Headmaster218/SkyGrip/Medias/Arm_load_test.PNG

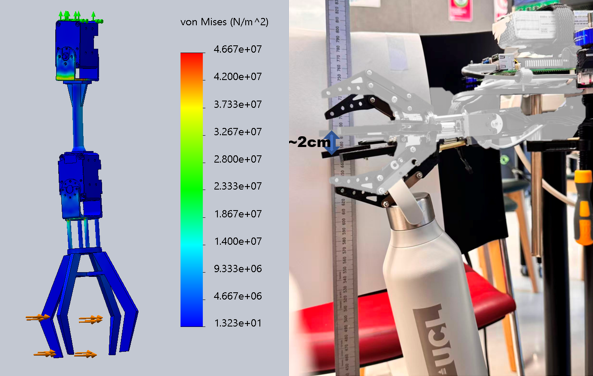
Medias/Arm_load_test.PNG
