Headmaster218/SkyGrip/3D Model/Manipulator/pics/Raspberry Pi 5.JPG

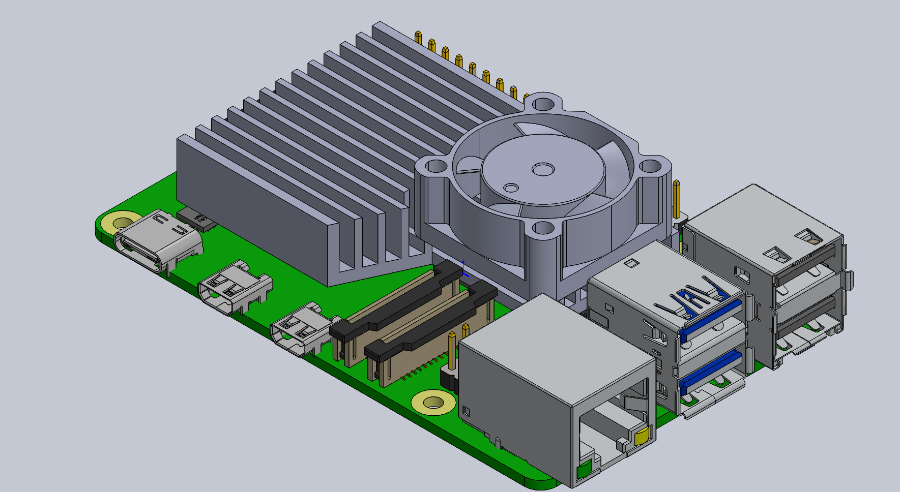
3D Model/Manipulator/pics/Raspberry Pi 5.JPG
