Headmaster218/SkyGrip/3D Model/Manipulator/pics/Arm_FEA1.PNG

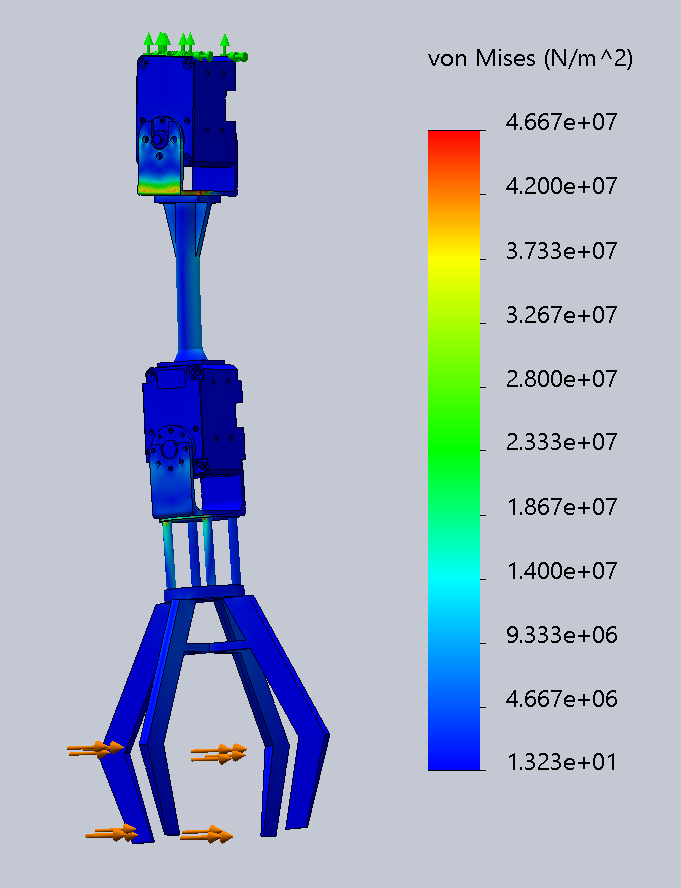
3D Model/Manipulator/pics/Arm_FEA1.PNG
