Headmaster218/SkyGrip/3D Model/Manipulator/pics/Arm_FEA.PNG

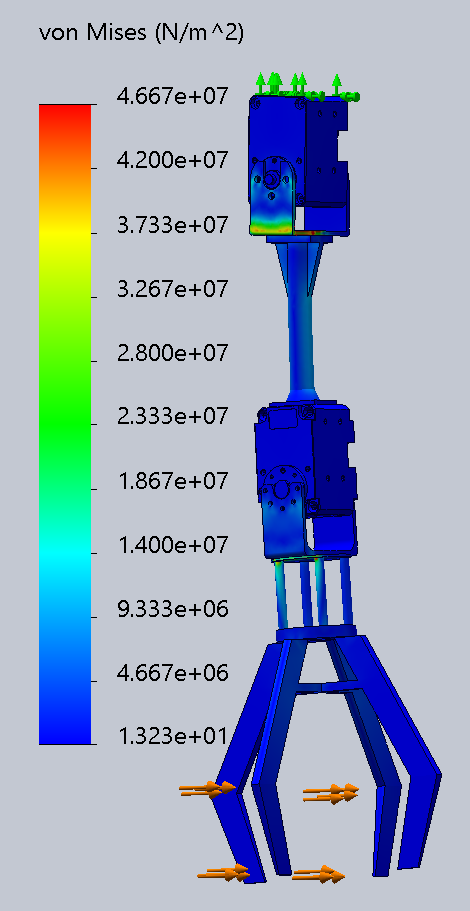
3D Model/Manipulator/pics/Arm_FEA.PNG
