Headmaster218/SkyGrip/3D Model/Manipulator/pics/arm_link.JPG

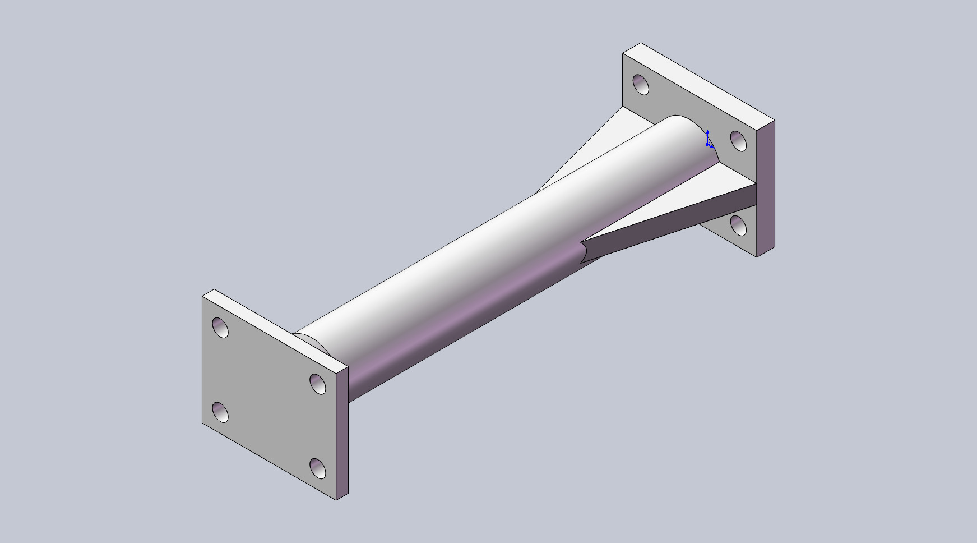
3D Model/Manipulator/pics/arm_link.JPG
