Headmaster218/SkyGrip/3D Model/Manipulator/pics/claw open.JPG

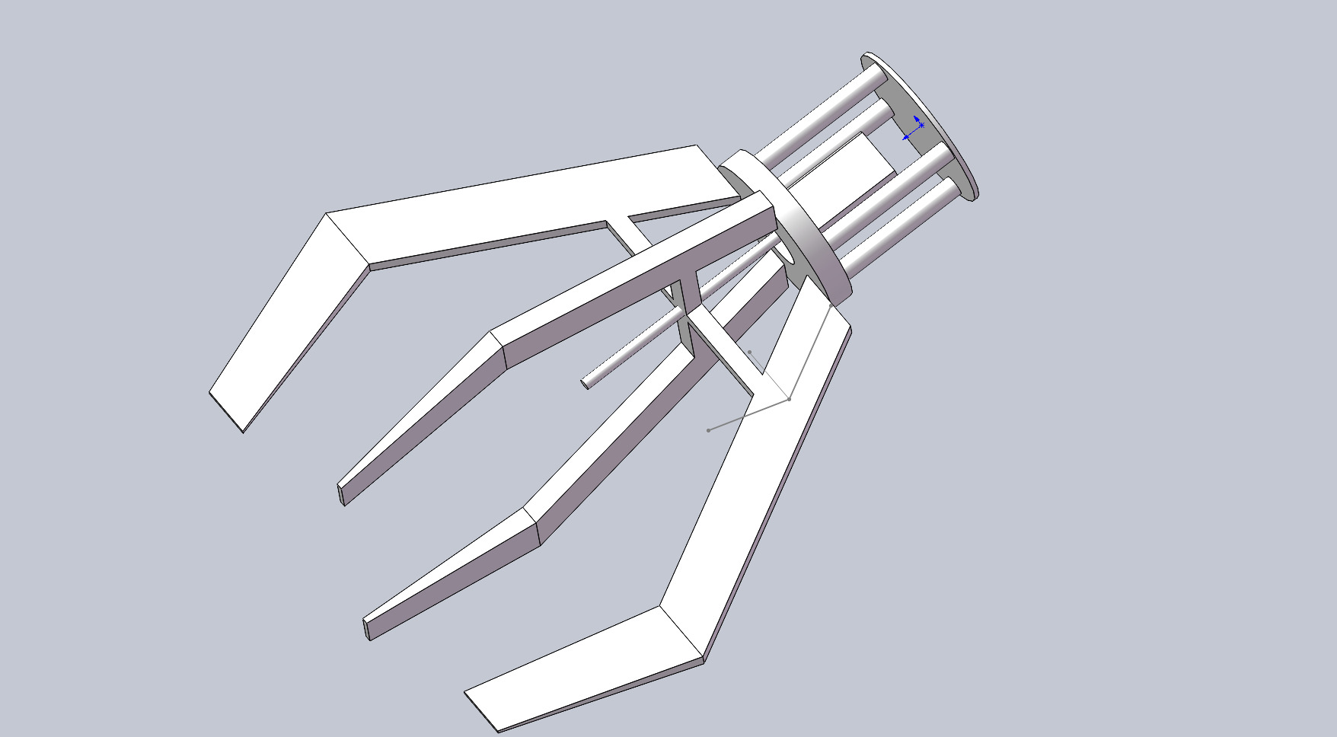
3D Model/Manipulator/pics/claw open.JPG
