Headmaster218/SkyGrip/3D Model/Manipulator/pics/connector_joint1.JPG

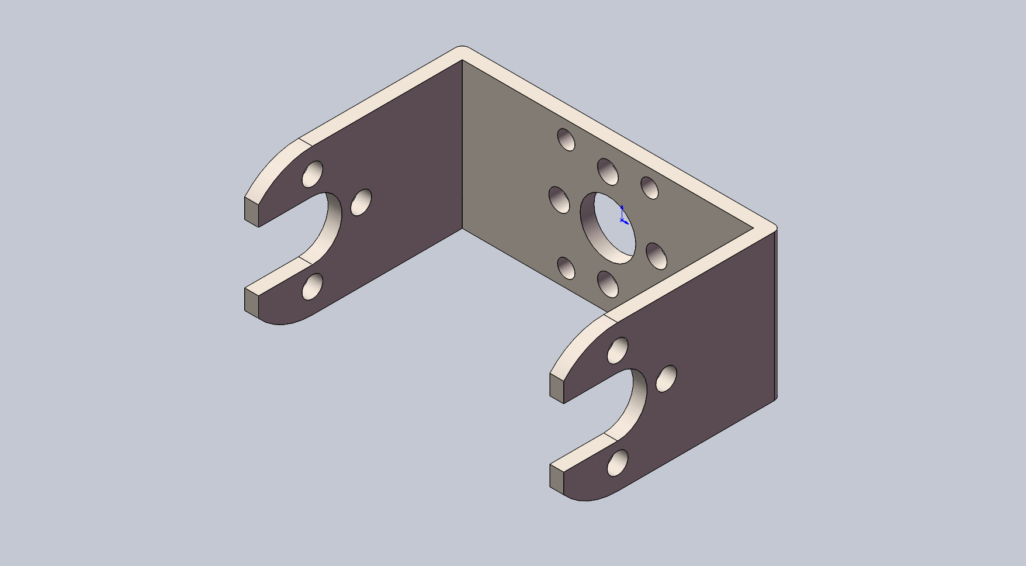
3D Model/Manipulator/pics/connector_joint1.JPG
