Headmaster218/SkyGrip/3D Model/Manipulator/pics/drone.JPG

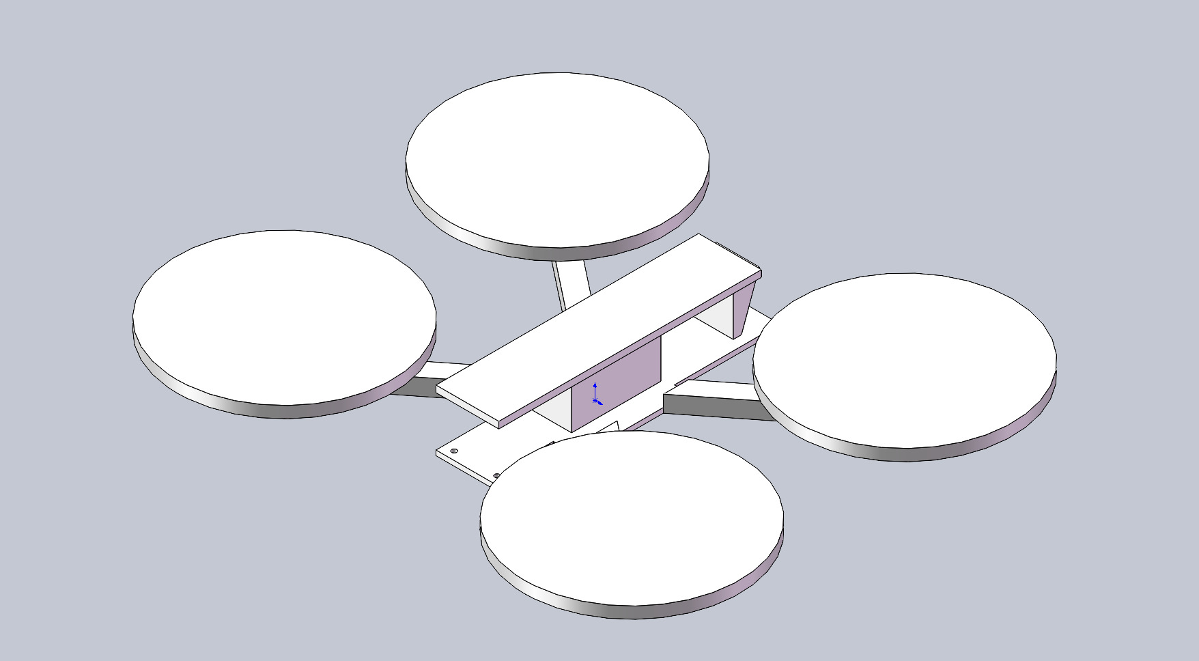
3D Model/Manipulator/pics/drone.JPG
