Headmaster218/SkyGrip/3D Model/Manipulator/pics/motor2.JPG

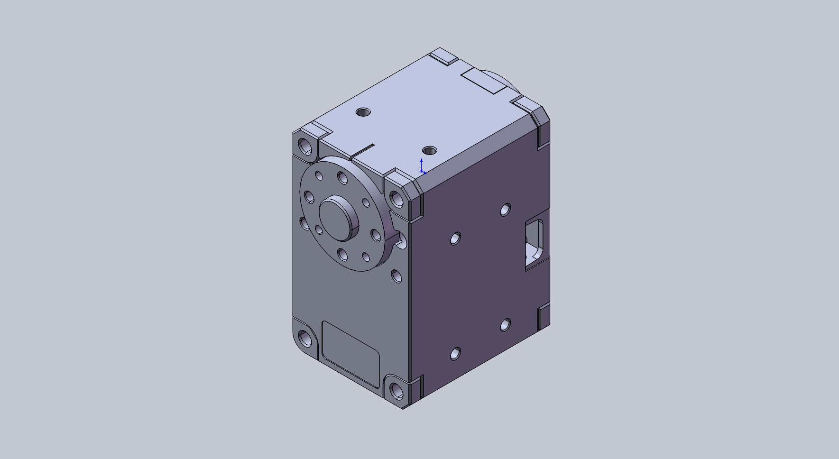
3D Model/Manipulator/pics/motor2.JPG
