Headmaster218/SkyGrip/3D Model/Manipulator/pics/motor2drone.JPG

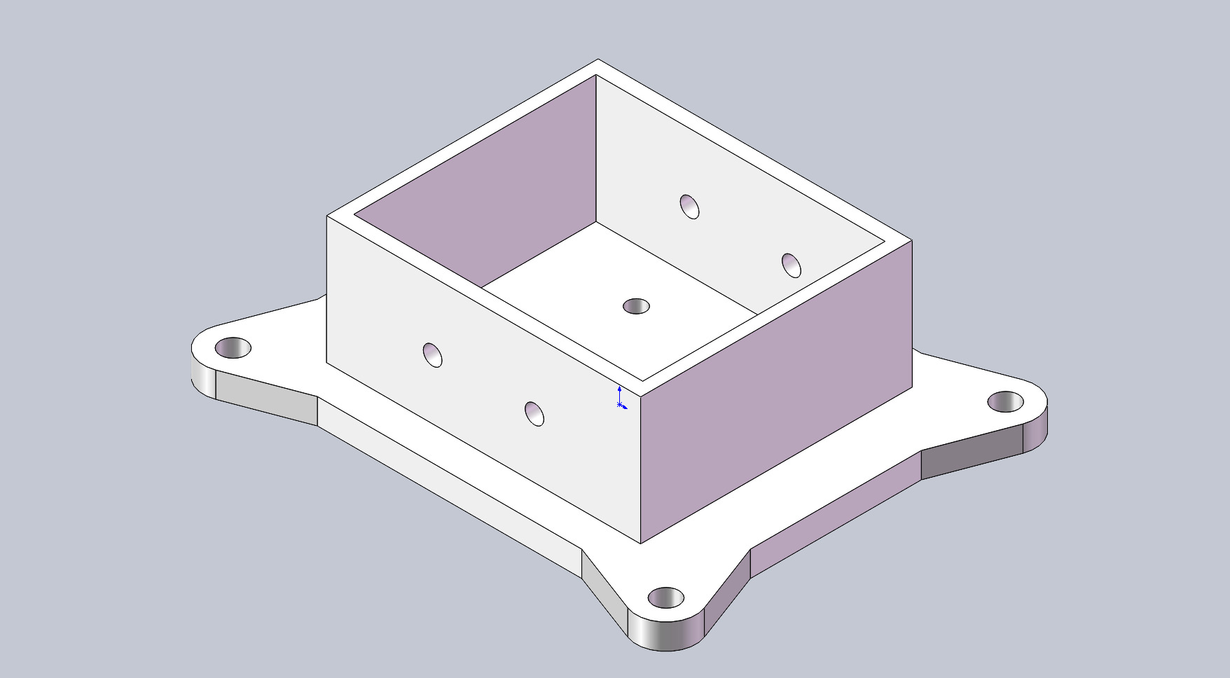
3D Model/Manipulator/pics/motor2drone.JPG
