Headmaster218/SkyGrip/3D Model/Manipulator/pics/raspi_shelf.JPG

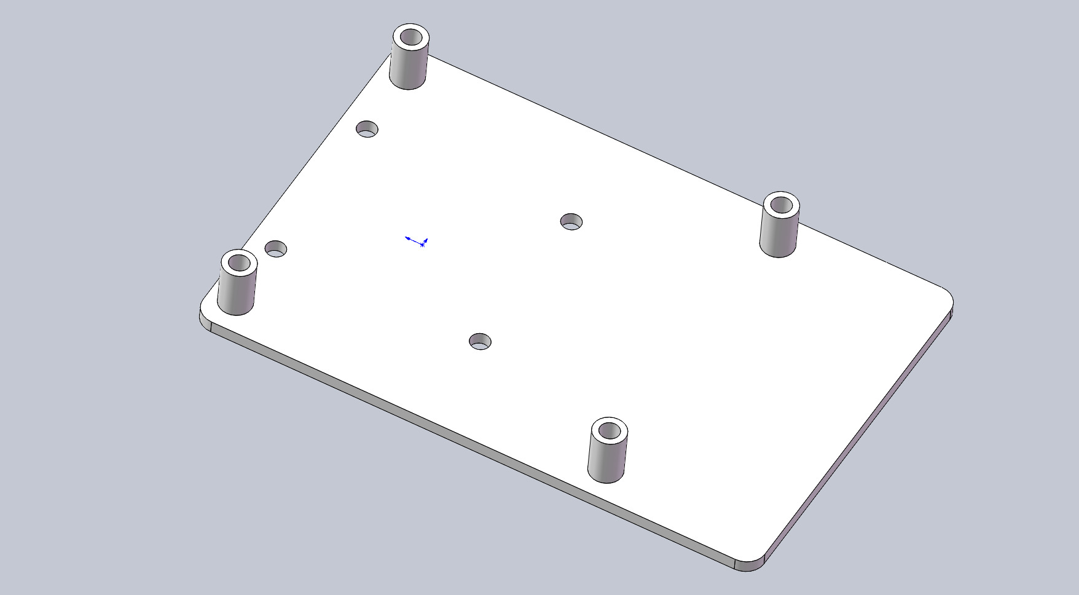
3D Model/Manipulator/pics/raspi_shelf.JPG
