Headmaster218/SkyGrip/Medias/EE_Square_rmse_heatmap.png

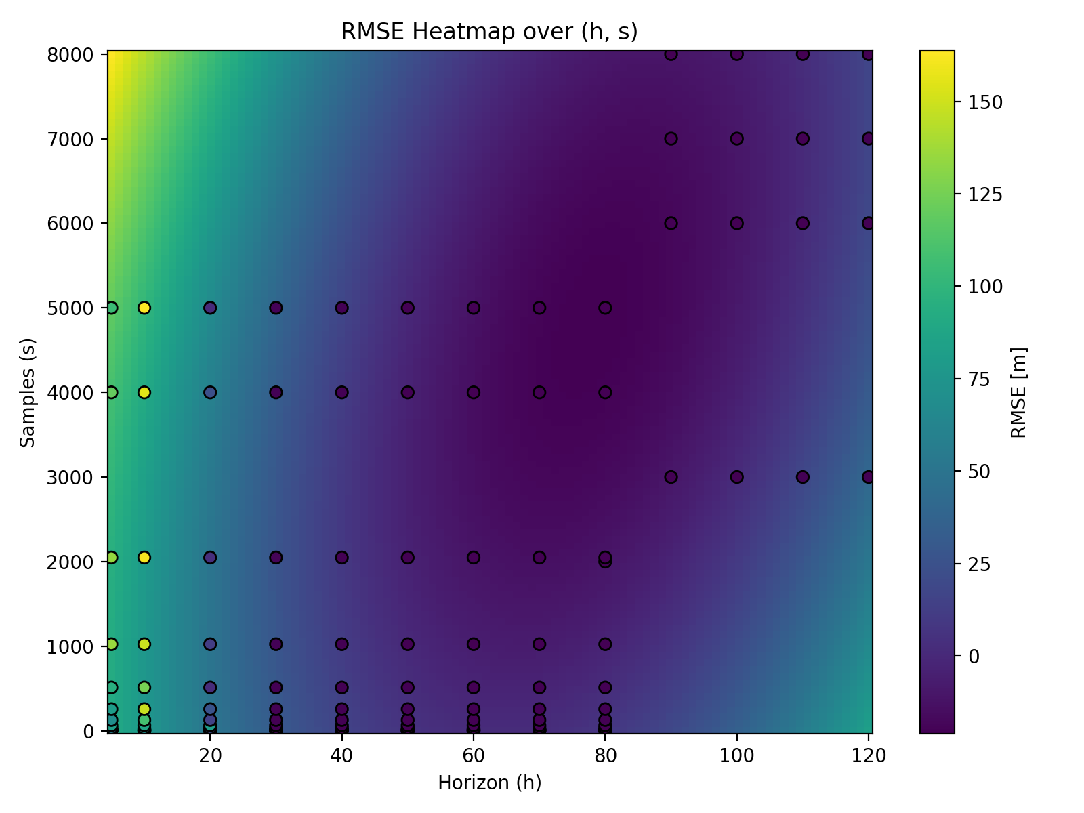
Medias/EE_Square_rmse_heatmap.png
