Headmaster218/SkyGrip/Medias/MPPI vs RS_MPC vs Myopic.png

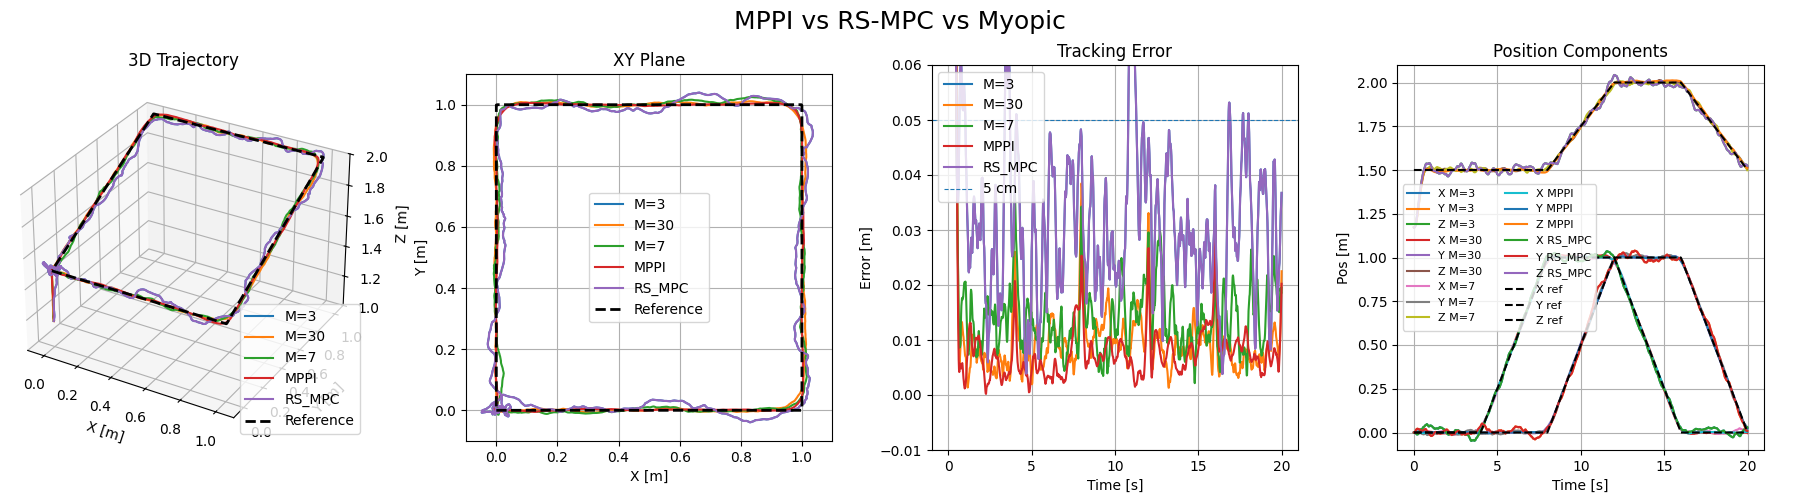
Medias/MPPI vs RS_MPC vs Myopic.png
