Headmaster218/SkyGrip/Medias/sim_n_real1.jpg

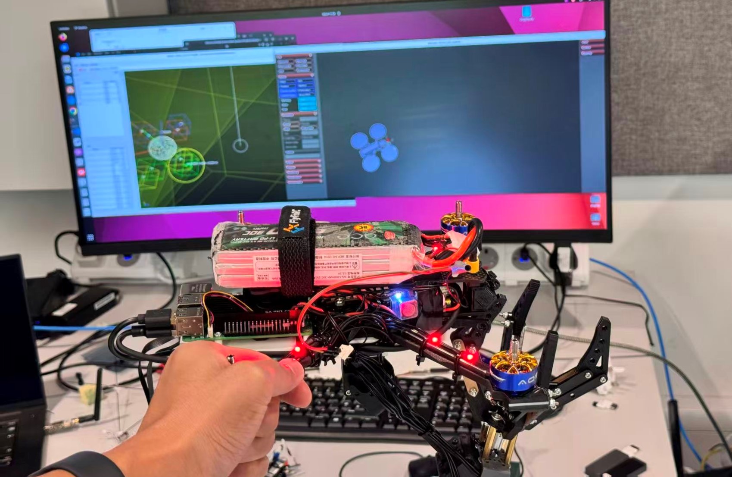
Medias/sim_n_real1.jpg
