Headmaster218/SkyGrip/Medias/sim_n_real.png

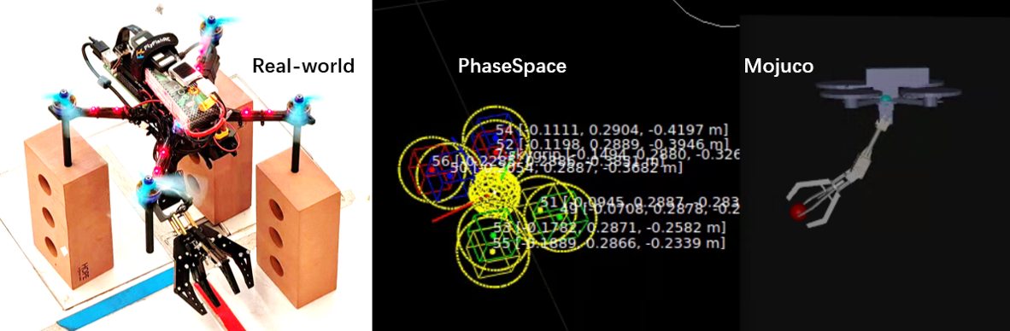
Medias/sim_n_real.png
