Headmaster218/SkyGrip/Medias/square_trace_H_80.png

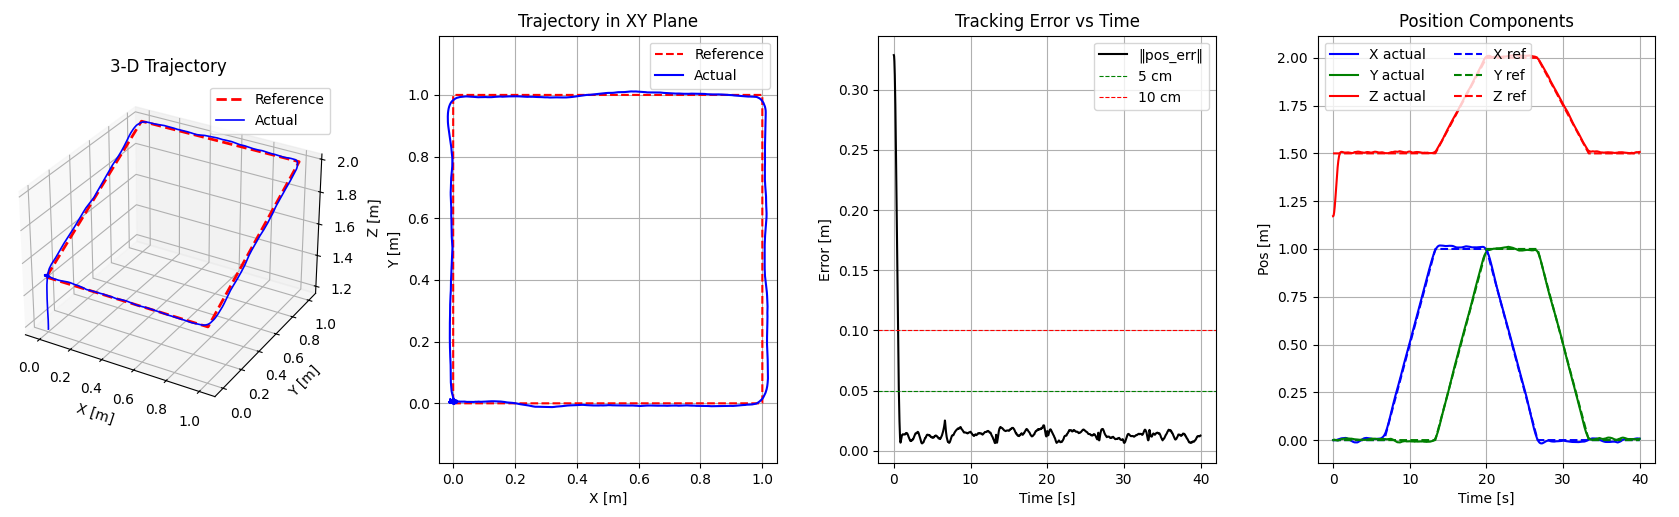
Medias/square_trace_H_80.png
