Headmaster218/SkyGrip/Medias/square_trace_H_80_remove_part_loss.png

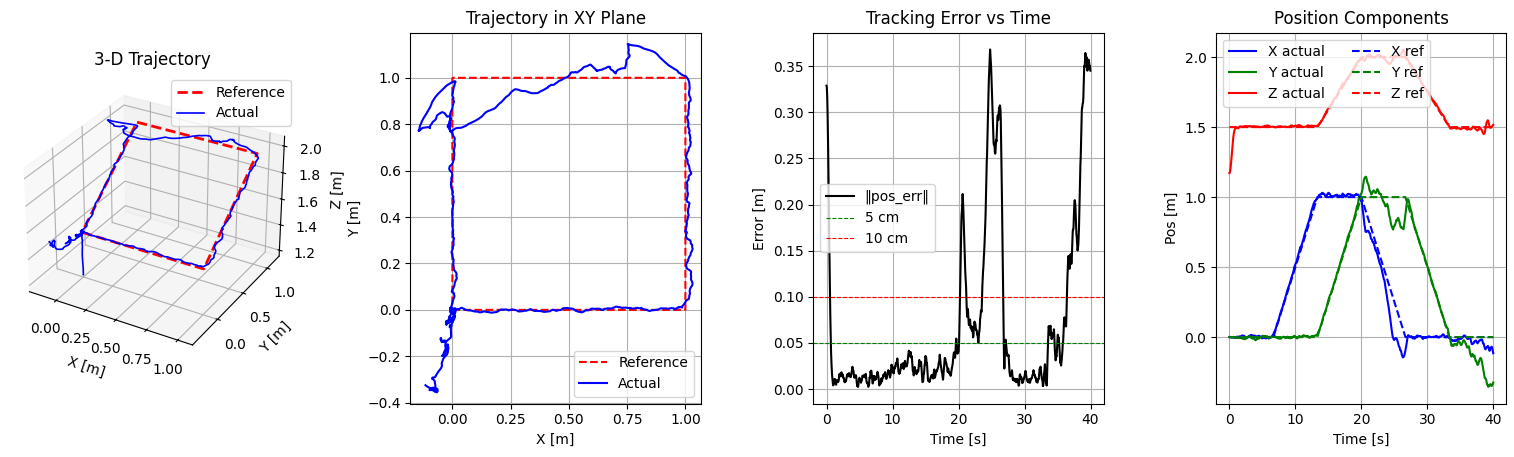
Medias/square_trace_H_80_remove_part_loss.png
