Headmaster218/SkyGrip/Medias/sys_archetecture_rough.PNG

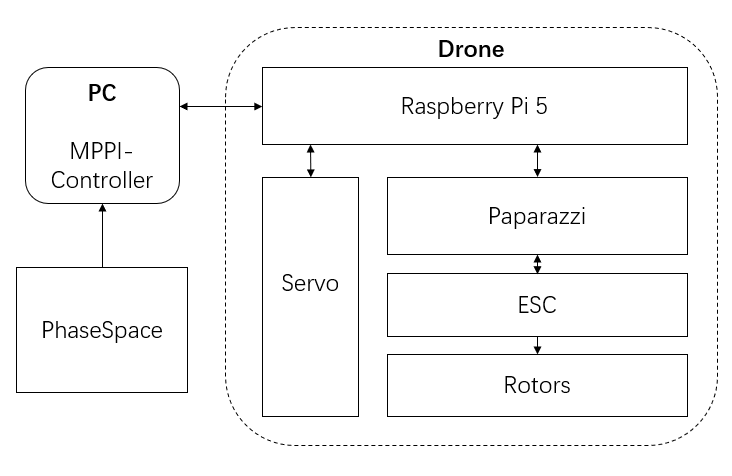
Medias/sys_archetecture_rough.PNG
