Headmaster218/SkyGrip/Sim'n'Real/Mujoco/base_link.STL

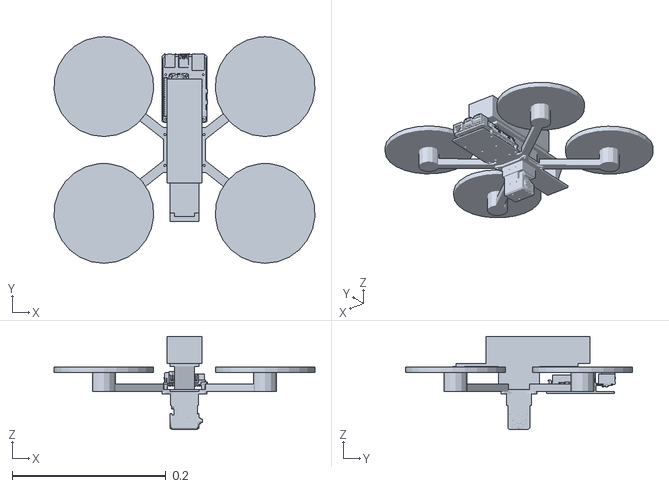
[picture p34: CAD file, 2025-08-15]
Sim'n'Real/Mujoco/base_link.STL
0.34 x 0.295 x 0.121
