Headmaster218/SkyGrip/Sim'n'Real/PyBullet/models/mppi/Link_2.stl

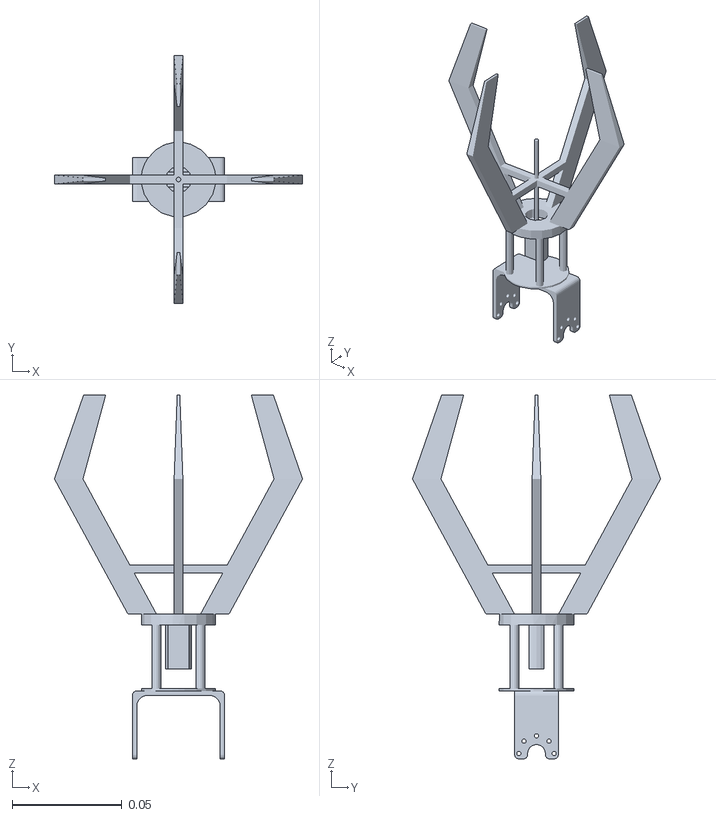
[picture p35: CAD file, 2025-08-08]
Sim'n'Real/PyBullet/models/mppi/Link_2.stl
0.113 x 0.113 x 0.166
