Headmaster218/SkyGrip/3D Model/Manipulator/motor2drone.STEP

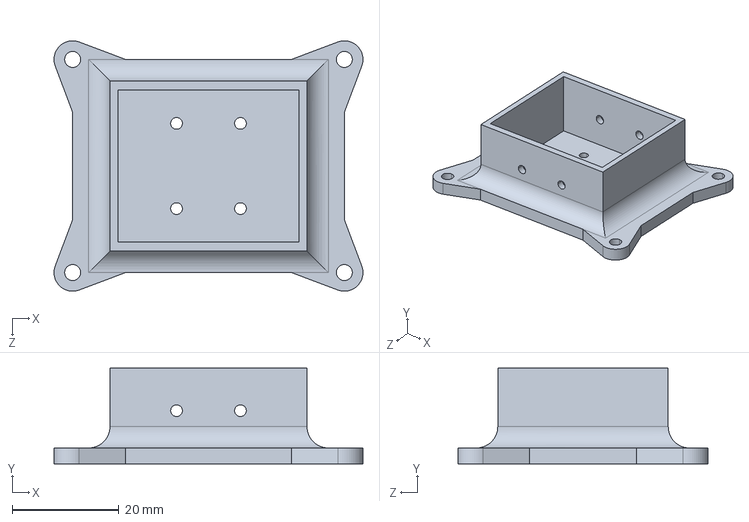
[picture p36: CAD file, 2025-09-08]
3D Model/Manipulator/motor2drone.STEP
58.0 x 18.0 x 47.0 mm
