Headmaster218/SkyGrip/3D Model/Supersonic/realsense.SLDPRT

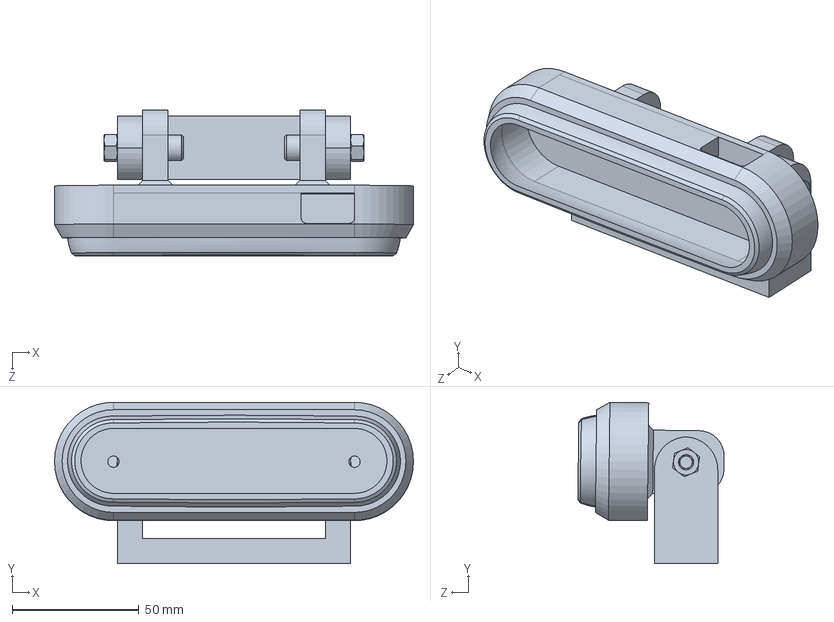
[picture p37: CAD file, 2025-08-19]
3D Model/Supersonic/realsense.SLDPRT
141.5 x 63.6 x 57.7 mm
