Headmaster218/SkyGrip/Sim'n'Real/Mujoco/Link_1.STL

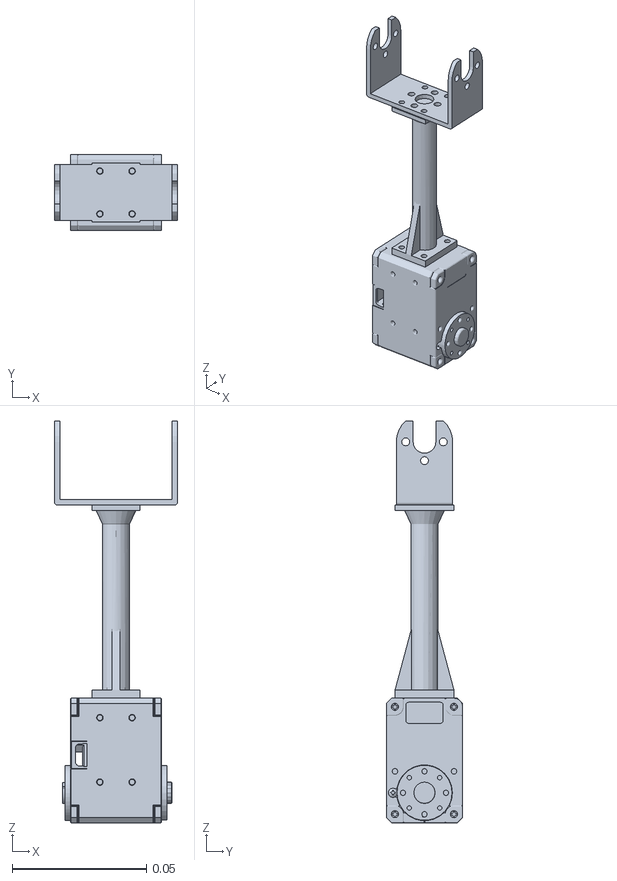
[picture p38: CAD file, 2025-08-08]
Sim'n'Real/Mujoco/Link_1.STL
0.0459 x 0.0285 x 0.15
