Headmaster218/SkyGrip/Sim'n'Real/PyBullet/models/mppi/Link_1.stl

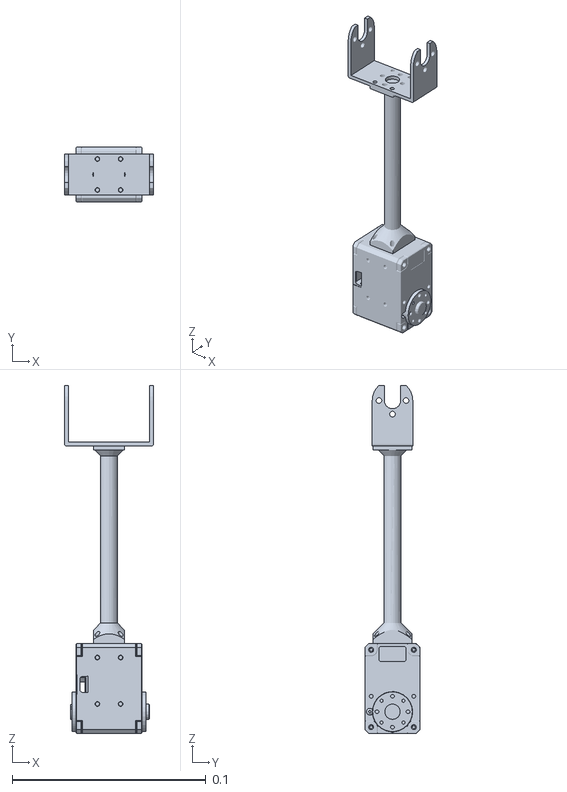
[picture p39: CAD file, 2025-06-22]
Sim'n'Real/PyBullet/models/mppi/Link_1.stl
0.0459 x 0.0285 x 0.18
