Headmaster218/SkyGrip/3D Model/Manipulator/arm.SLDPRT

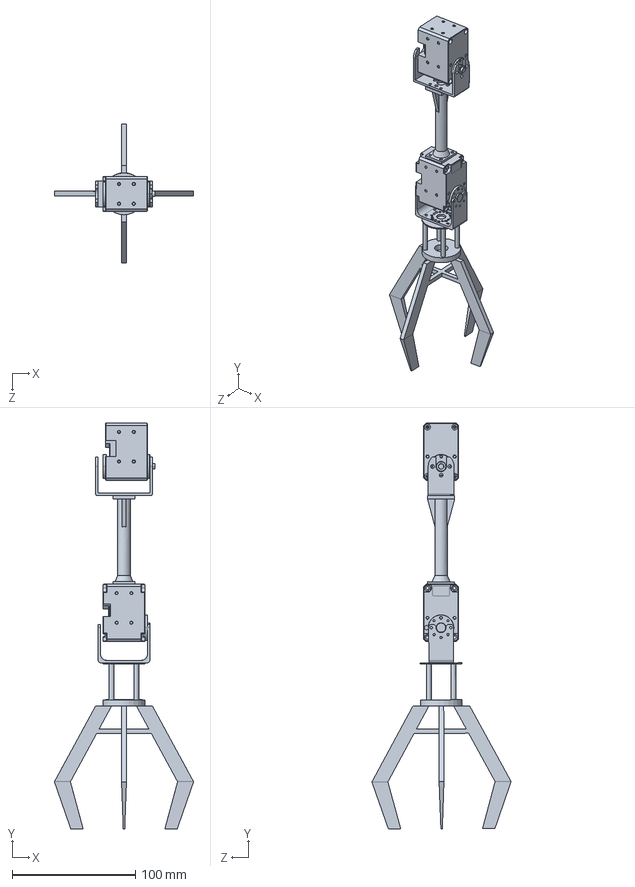
[picture p40: CAD file, 2025-09-04]
3D Model/Manipulator/arm.SLDPRT
113.0 x 329.4 x 113.0 mm
