Headmaster218/SkyGrip/3D Model/Supersonic/L_for_big.STEP

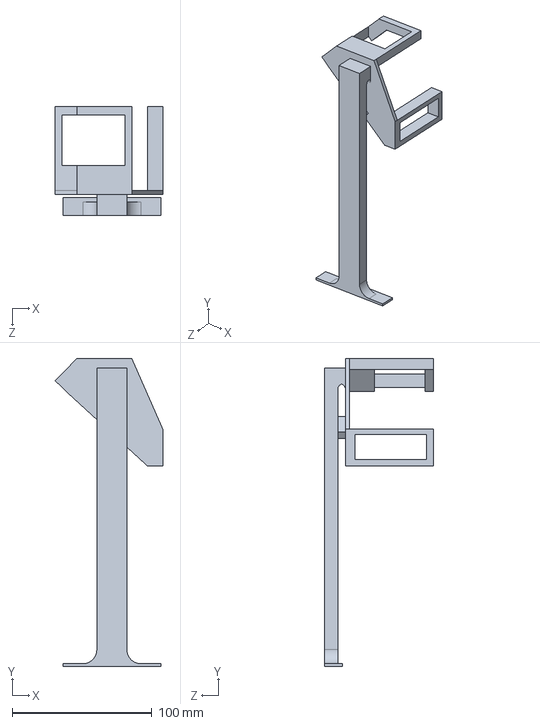
[picture p41: CAD file, 2025-08-18]
3D Model/Supersonic/L_for_big.STEP
76.9 x 220.1 x 78.0 mm
