Headmaster218/SkyGrip/Sim'n'Real/PyBullet/models/mppi/base_link.stl

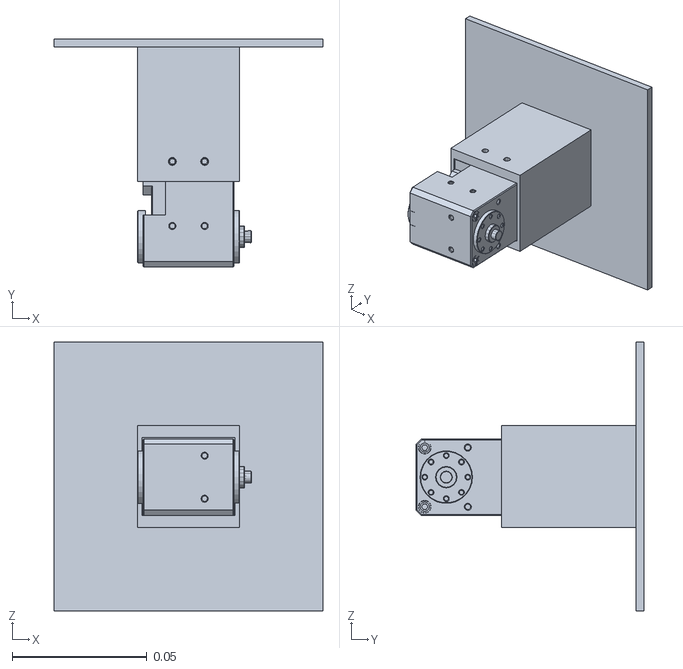
[picture p42: CAD file, 2025-06-22]
Sim'n'Real/PyBullet/models/mppi/base_link.stl
0.1 x 0.0848 x 0.1
