Headmaster218/SkyGrip/3D Model/Manipulator/drone_foot.STEP

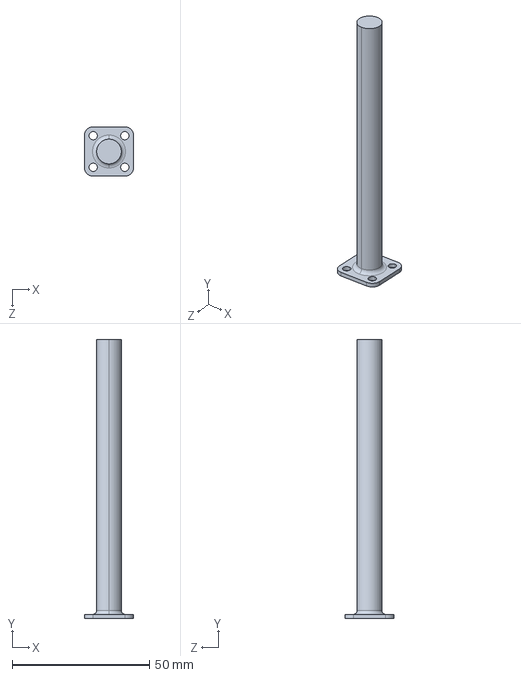
[picture p43: CAD file, 2025-09-04]
3D Model/Manipulator/drone_foot.STEP
18.0 x 101.5 x 18.0 mm
