Headmaster218/SkyGrip/3D Model/Supersonic/L_for_small.SLDPRT

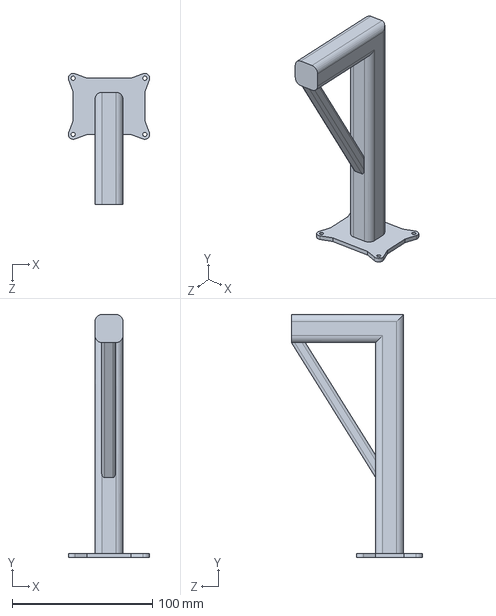
[picture p44: CAD file, 2025-08-18]
3D Model/Supersonic/L_for_small.SLDPRT
58.0 x 173.0 x 93.5 mm
