Headmaster218/SkyGrip/3D Model/Manipulator/drone.SLDPRT

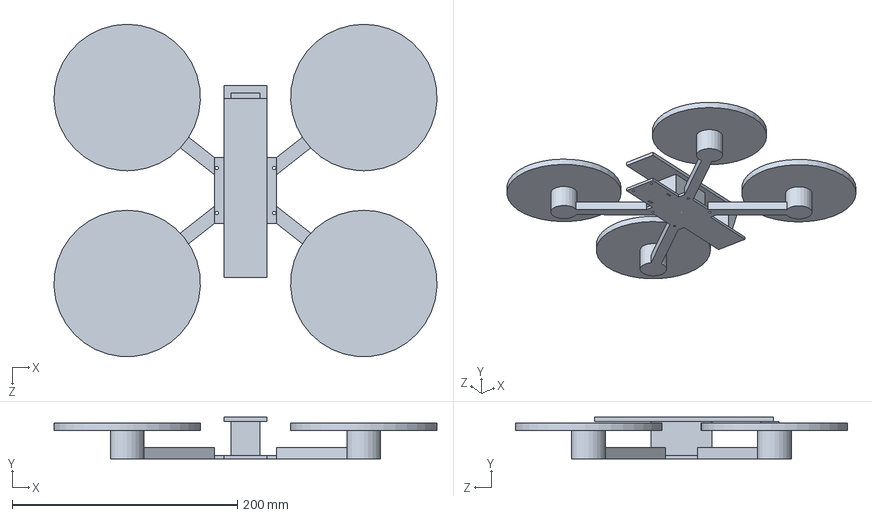
[picture p45: CAD file, 2025-08-08]
3D Model/Manipulator/drone.SLDPRT
339.9 x 37.0 x 295.0 mm
