Headmaster218/SkyGrip/3D Model/Manipulator/battery.SLDPRT

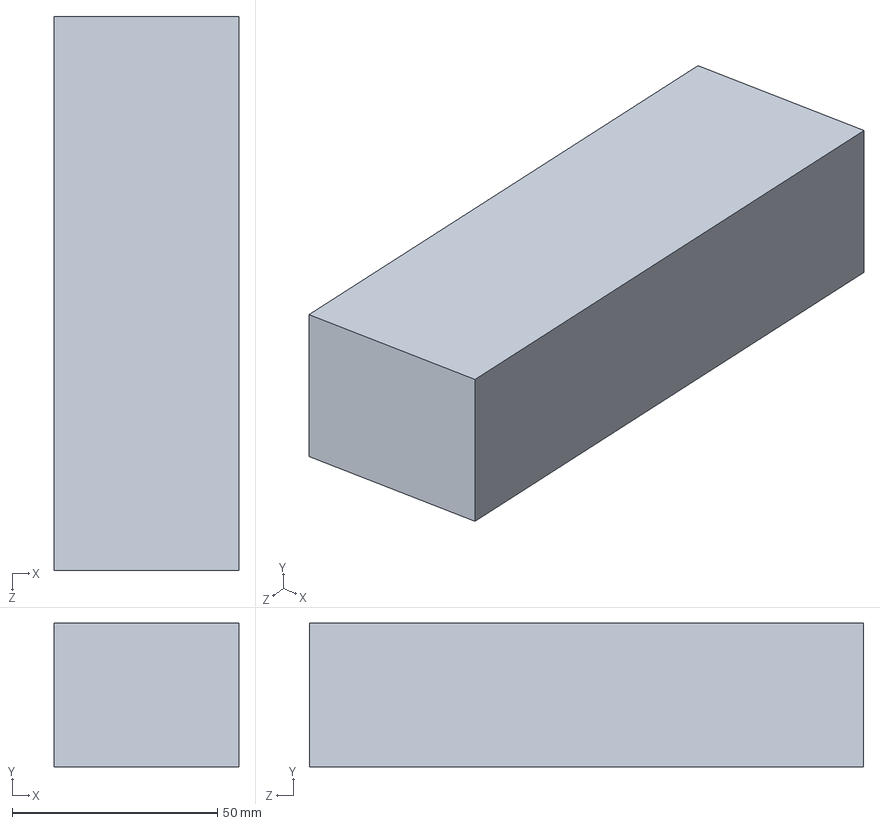
[picture p46: CAD file, 2025-08-07]
3D Model/Manipulator/battery.SLDPRT
45.0 x 35.0 x 135.0 mm
