Headmaster218/SkyGrip/3D Model/Manipulator/raspi_shelf.STEP

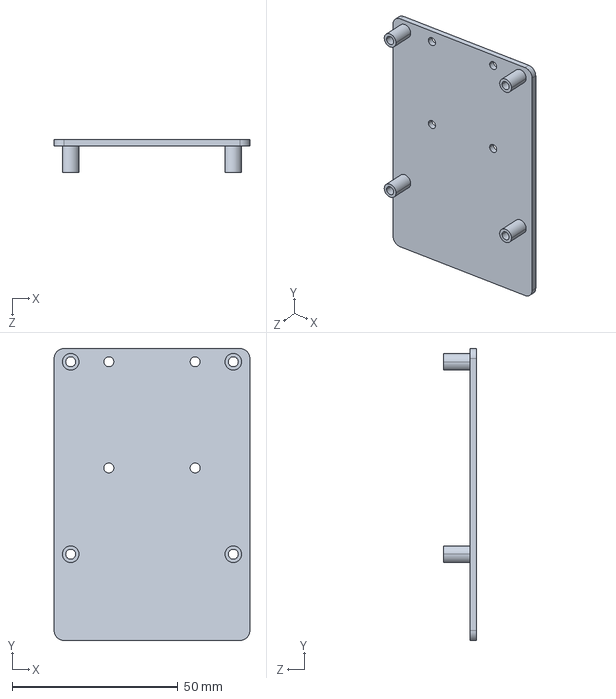
[picture p47: CAD file, 2025-08-07]
3D Model/Manipulator/raspi_shelf.STEP
59.0 x 88.0 x 10.0 mm
