Headmaster218/SkyGrip/3D Model/Manipulator/arm_link.STEP

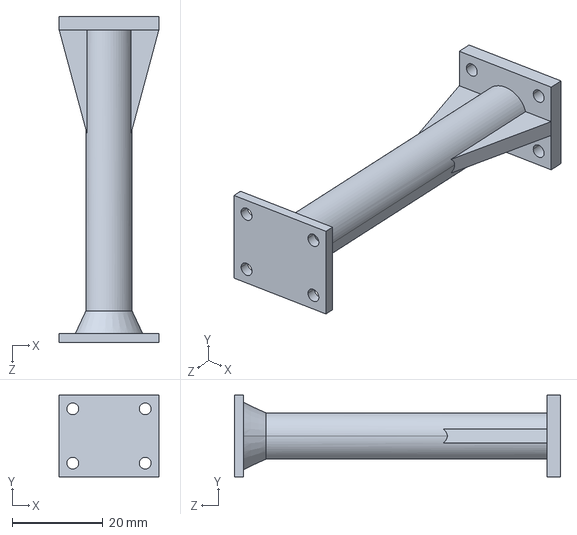
[picture p48: CAD file, 2025-08-06]
3D Model/Manipulator/arm_link.STEP
22.0 x 18.0 x 72.0 mm
