Headmaster218/SkyGrip/3D Model/Manipulator/connector_joint2.SLDPRT

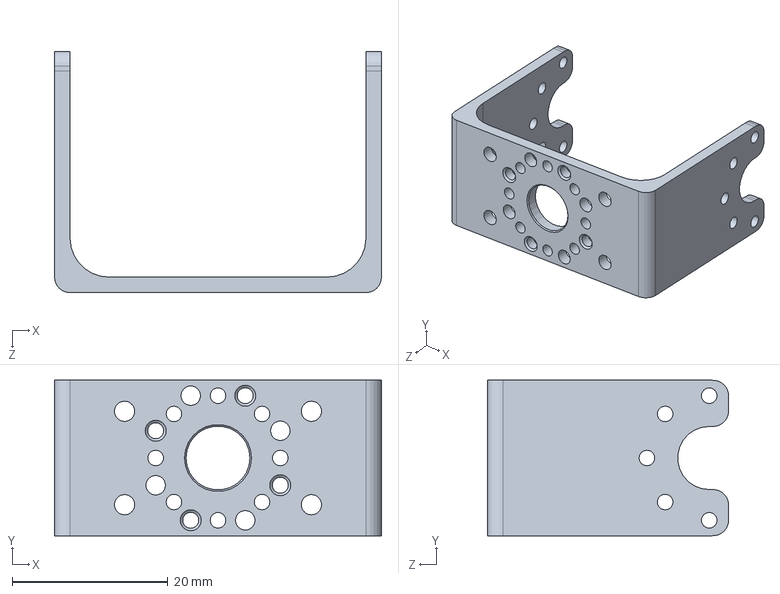
[picture p49: CAD file, 2025-08-06]
3D Model/Manipulator/connector_joint2.SLDPRT
42.0 x 20.0 x 31.0 mm
