Headmaster218/SkyGrip/3D Model/Manipulator/claw open.SLDPRT

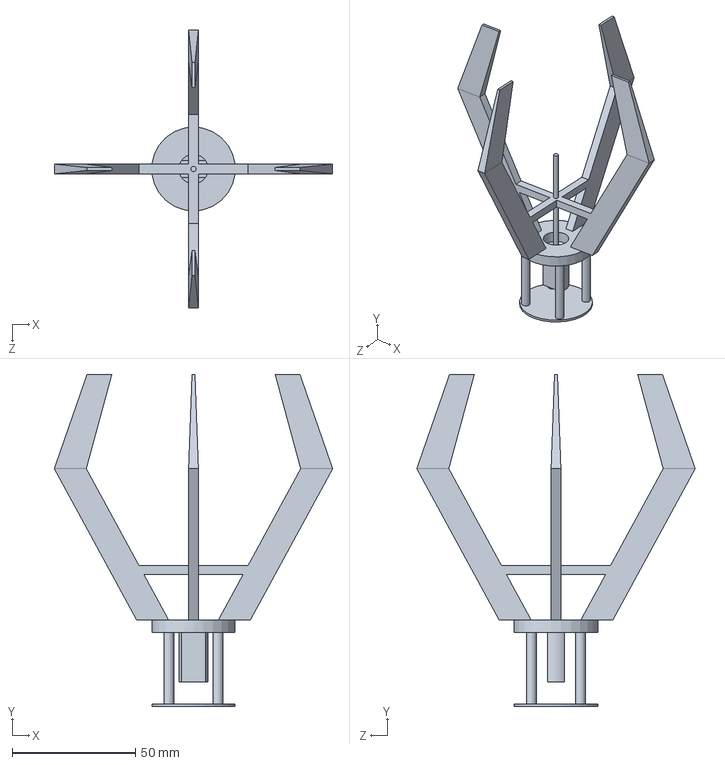
[picture p50: CAD file, 2025-08-06]
3D Model/Manipulator/claw open.SLDPRT
113.0 x 134.7 x 113.0 mm
