Headmaster218/SkyGrip/3D Model/Manipulator/motor2.SLDPRT

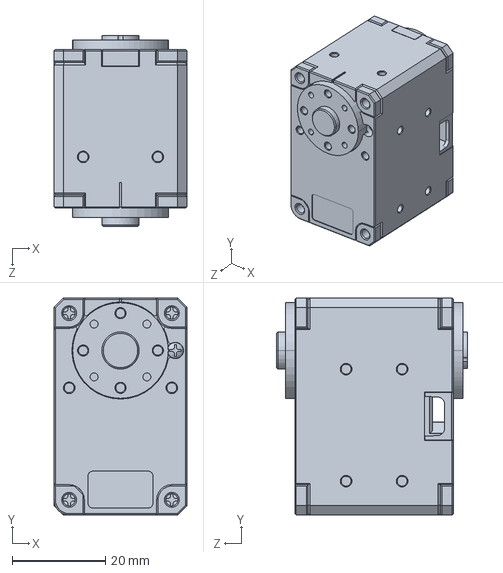
[picture p51: CAD file, 2025-06-22]
3D Model/Manipulator/motor2.SLDPRT
28.5 x 46.5 x 40.9 mm
