Headmaster218/SkyGrip/3D Model/Manipulator/connector_joint1.SLDPRT

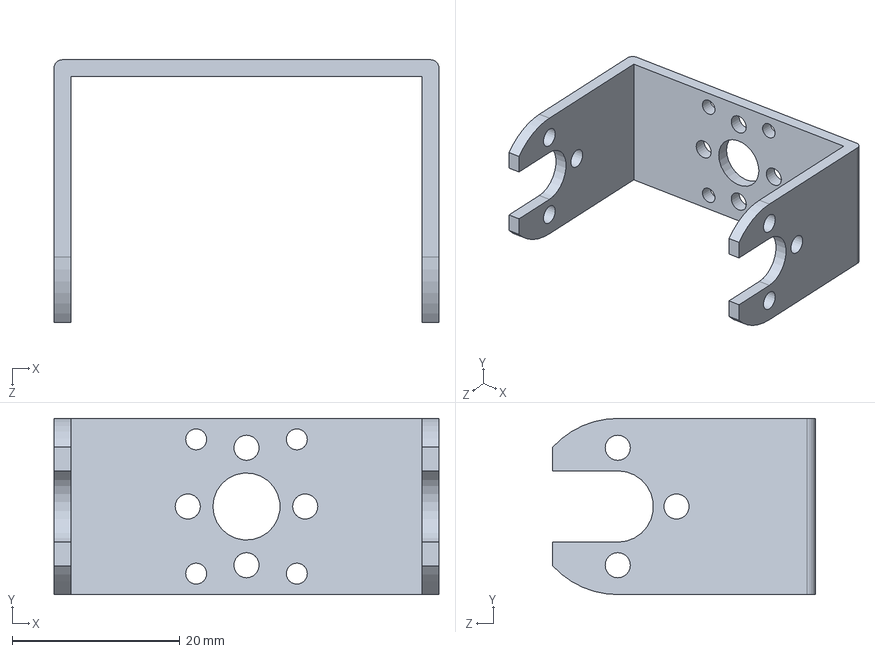
[picture p52: CAD file, 2025-06-22]
3D Model/Manipulator/connector_joint1.SLDPRT
45.9 x 21.0 x 31.3 mm
