Headmaster218/SkyGrip/3D Model/Manipulator/motor1.SLDPRT

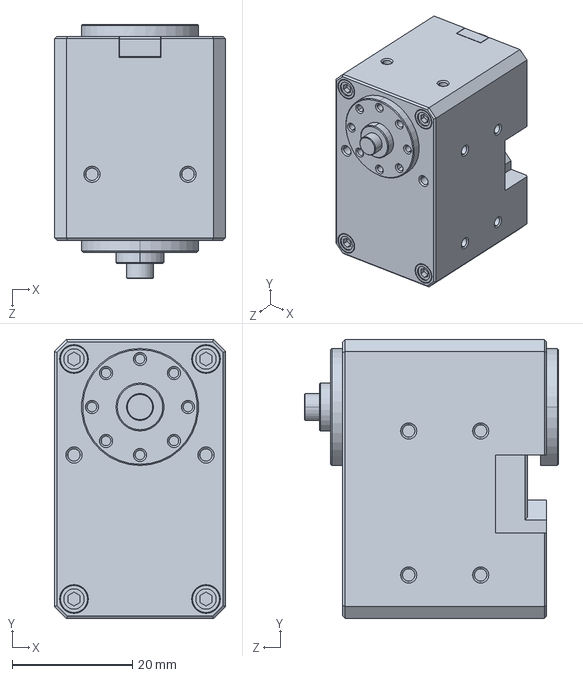
[picture p53: CAD file, 2025-06-22]
3D Model/Manipulator/motor1.SLDPRT
28.5 x 46.5 x 42.4 mm
