Headmaster218/SkyGrip/3D Model/Manipulator/Base.SLDPRT

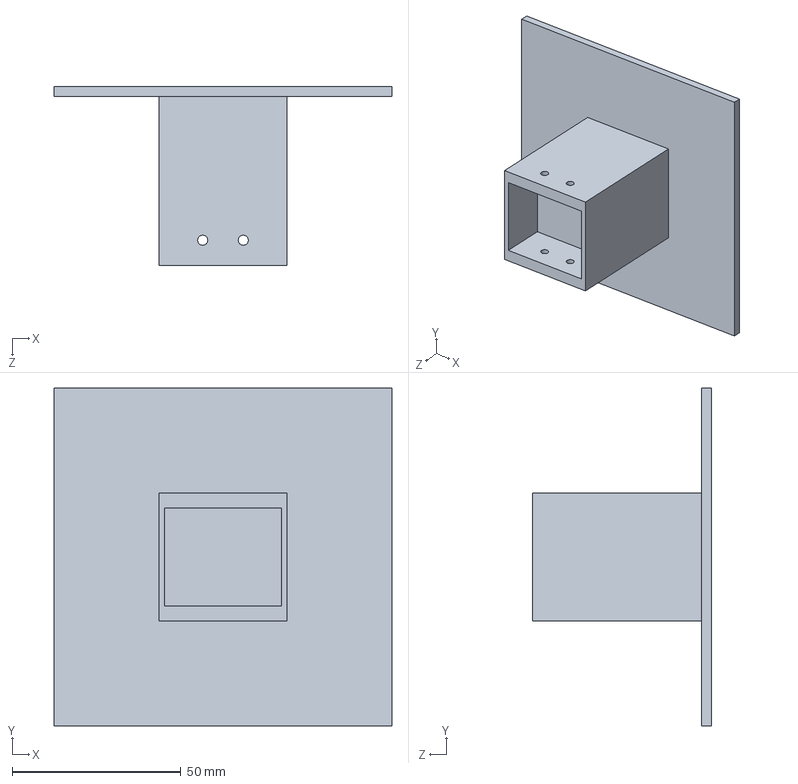
[picture p54: CAD file, 2025-06-22]
3D Model/Manipulator/Base.SLDPRT
100.0 x 100.0 x 53.0 mm
