Headmaster218/SkyGrip/3D Model/Manipulator/little bearing.SLDPRT

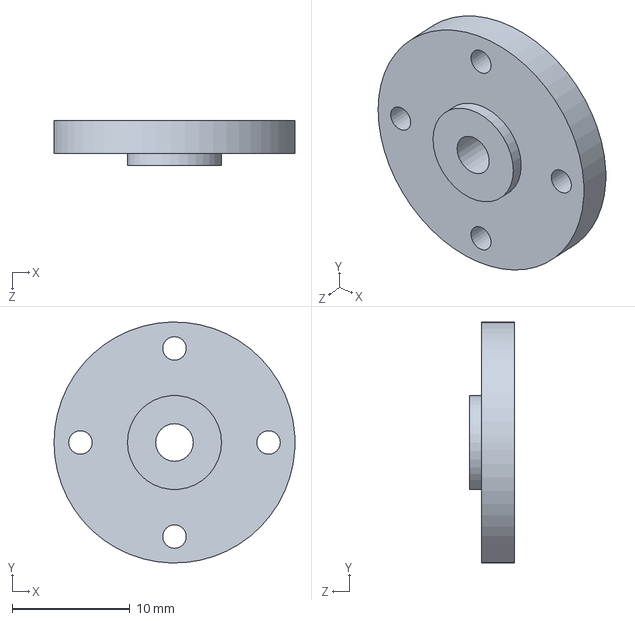
[picture p55: CAD file, 2025-06-22]
3D Model/Manipulator/little bearing.SLDPRT
20.5 x 20.5 x 3.80 mm
