Headmaster218/SkyGrip/3D Model/Manipulator/Skygrip.SLDASM

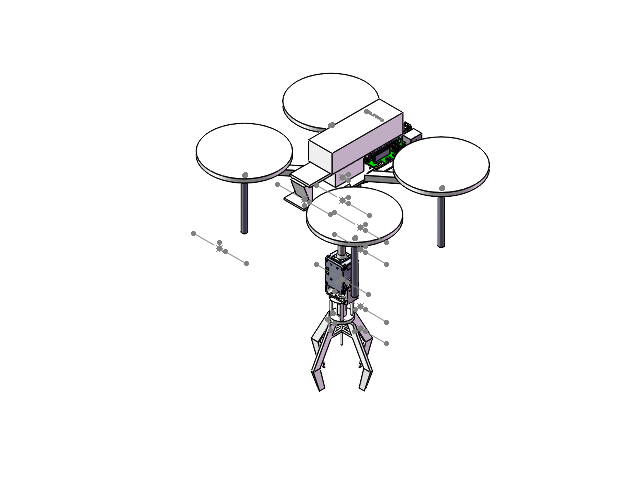
[picture p56: CAD file, 2025-09-08]
3D Model/Manipulator/Skygrip.SLDASM
connector_joint1
arm_link
connector_joint2
motor1
motor2
drone
claw open
raspi_shelf
Raspberry Pi 5
motor2drone
battery
drone_foot x 4
