Headmaster218/SkyGrip/3D Model/Supersonic/Link_2_new.SLDASM

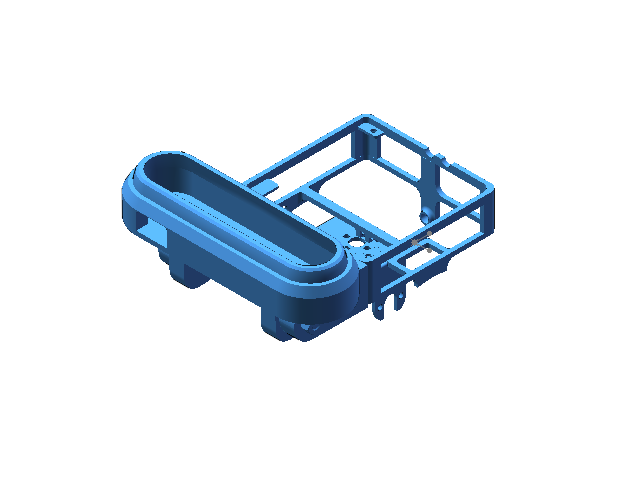
[picture p57: CAD file, 2025-08-20]
3D Model/Supersonic/Link_2_new.SLDASM
connector1
board_connector
realsense
