Headmaster218/SkyGrip/(list of files, cad)

Other CAD files:
3D Model/Manipulator/arm_link.SLDPRT
3D Model/Manipulator/drone_foot.SLDPRT
3D Model/Manipulator/motor2drone.SLDPRT
3D Model/Manipulator/raspi_shelf.SLDPRT
3D Model/Supersonic/L_for_big.SLDPRT
3D Model/Supersonic/Link_2_new.STL
