Headmaster218/SkyGrip/3D Model/Manipulator/PerformanceLog.txt

Number of Contacts: 32
Number of contact data: 5015
