Headmaster218/SkyGrip/Medias/Arm Perturbation test.png

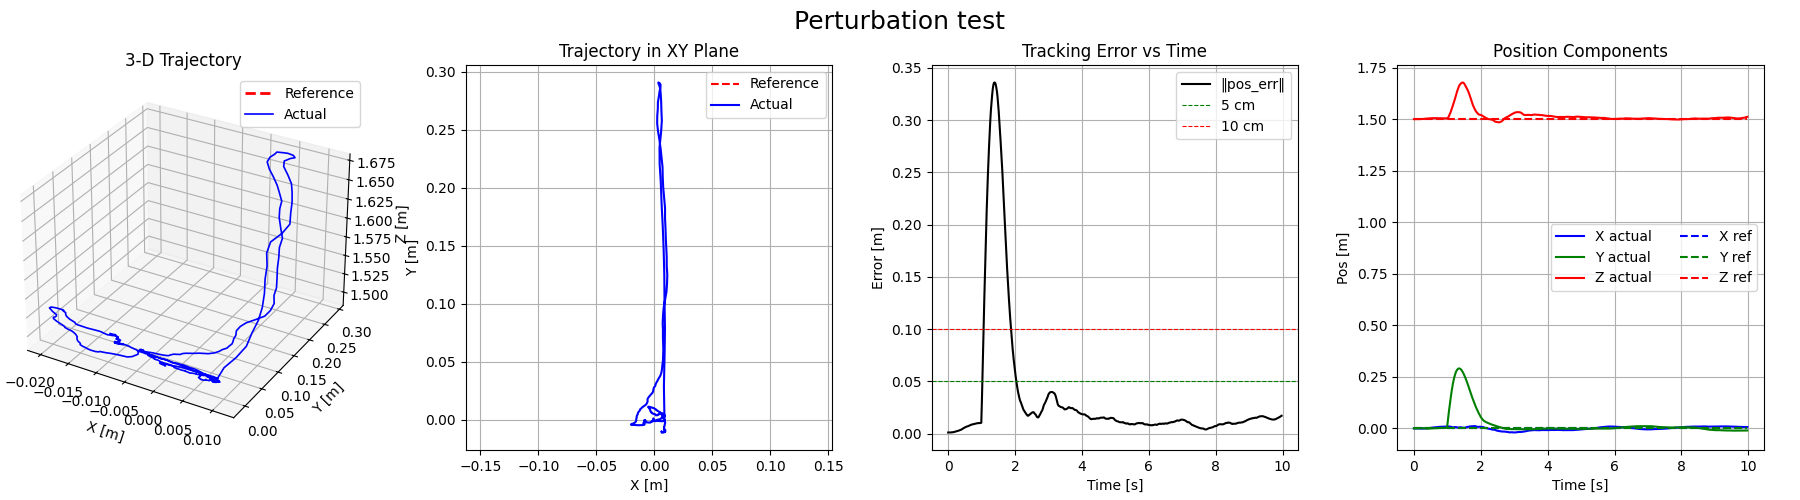
Medias/Arm Perturbation test.png
