Headmaster218/SkyGrip/Sim'n'Real/Mujoco/SkyGrip_URDF.urdf

<?xml version="1.0" encoding="utf-8"?>
<!-- This URDF was automatically created by SolidWorks to URDF Exporter! Originally created by Stephen Brawner (brawner@gmail.com) 
     Commit Version: 1.6.0-4-g7f85cfe  Build Version: 1.6.7995.38578
     For more information, please see http://wiki.ros.org/sw_urdf_exporter -->
<robot name="SkyGrip_URDF">
  <link name="base_link">
    <inertial>
      <origin xyz="-1.928E-06 0.0086666 0.027403" rpy="0 0 0" />
      <mass value="1" />
      <inertia ixx="0.00409" ixy="2.7055E-07" ixz="-2.1861E-08" iyy="0.0055803" iyz="-4.2593E-06" izz="0.0094981" />
    </inertial>
    <visual>
      <origin xyz="0 0 0" rpy="0 0 0" />
      <geometry>
        <mesh filename="package://SkyGrip_URDF/meshes/base_link.STL" />
      </geometry>
      <material name="">
        <color rgba="0.79216 0.81961 0.93333 1" />
      </material>
    </visual>
    <collision>
      <origin xyz="0 0 0" rpy="0 0 0" />
      <geometry>
        <mesh filename="package://SkyGrip_URDF/meshes/base_link.STL" />
      </geometry>
    </collision>
  </link>
  <link name="Link_1">
    <inertial>
      <origin xyz="-0.0016184 -7.0854E-06 -0.08892" rpy="0 0 0" />
      <mass value="0.08" />
      <inertia ixx="1.7491E-05" ixy="-5.233E-09" ixz="2.555E-07" iyy="2.2905E-05" iyz="4.4082E-09" izz="1.2229E-05" />
    </inertial>
    <visual>
      <origin xyz="0 0 0" rpy="0 0 0" />
      <geometry>
        <mesh filename="package://SkyGrip_URDF/meshes/Link_1.STL" />
      </geometry>
      <material name="">
        <color rgba="1 0.94902 0.89804 1" />
      </material>
    </visual>
    <collision>
      <origin xyz="0 0 0" rpy="0 0 0" />
      <geometry>
        <mesh filename="package://SkyGrip_URDF/meshes/Link_1.STL" />
      </geometry>
    </collision>
  </link>
  <joint name="Joint_1" type="continuous">
    <origin xyz="0 -2.5E-05 -0.038" rpy="-0.00065513 0 0" />
    <parent link="base_link" />
    <child link="Link_1" />
    <axis xyz="1 0 0" />
    <limit lower="-0.8" upper="0.8" effort="0" velocity="0" />
  </joint>
  <link name="Link_2">
    <inertial>
      <origin xyz="-0.00195 -1.0507E-15 0.079412" rpy="0 0 0" />
      <mass value="0.105" />
      <inertia ixx="4.0466E-05" ixy="1.162E-19" ixz="-9.7885E-20" iyy="4.165E-05" iyz="1.7355E-19" izz="2.8062E-05" />
    </inertial>
    <visual>
      <origin xyz="0 0 0" rpy="0 0 0" />
      <geometry>
        <mesh filename="package://SkyGrip_URDF/meshes/Link_2.STL" />
      </geometry>
      <material name="">
        <color rgba="1 1 1 1" />
      </material>
    </visual>
    <collision>
      <origin xyz="0 0 0" rpy="0 0 0" />
      <geometry>
        <mesh filename="package://SkyGrip_URDF/meshes/Link_2.STL" />
      </geometry>
    </collision>
  </link>
  <joint name="Joint_2" type="continuous">
    <origin xyz="0 0 -0.1308" rpy="-3.1379 0 0" />
    <parent link="Link_1" />
    <child link="Link_2" />
    <axis xyz="1 0 0" />
    <limit lower="-0.8" upper="0.8" effort="0" velocity="0" />
  </joint>
</robot>


  <worldbody>
    <geom type="mesh" rgba="0.79216 0.81961 0.93333 1" mesh="base_link"/>
    <body name="Link_1" pos="0 -2.5e-05 -0.038" quat="1 -0.000327565 0 0">
      <inertial pos="-0.0016184 -7.0854e-06 -0.08892" quat="0.706568 -0.0169656 -0.0172577 0.707231" mass="0.08" diaginertia="2.2905e-05 1.75034e-05 1.22166e-05"/>
      <joint name="Joint_1" pos="0 0 0" axis="1 0 0" range="-0.8 0.8"/>
      <geom type="mesh" rgba="1 0.94902 0.89804 1" mesh="Link_1"/>
      <body name="Link_2" pos="0 0 -0.1308" quat="0.00184633 -0.999998 0 0">
        <inertial pos="-0.00195 0 0.079412" quat="0.707107 0 0 0.707107" mass="0.105" diaginertia="4.165e-05 4.0466e-05 2.8062e-05"/>
        <joint name="Joint_2" pos="0 0 0" axis="1 0 0" range="-0.8 0.8"/>
        <geom type="mesh" rgba="1 1 1 1" mesh="Link_2"/>
      </body>
    </body>
  </worldbody>
</mujoco>
