Headmaster218/SkyGrip/(commit log)

2025-06-14 Arm design
    [Base.SLDPRT, Manipulator.SLDASM, XM,H-430_idler.SLDASM, XM,H-430_idler.stp, arm1.SLDPRT, connector1.SLDPRT, little bearing.SLDPRT, motor2.SLDASM]
2025-06-16 step version
    [Base.STEP, arm1.STEP, little bearing.SLDPRT, little bearing.STEP]
2025-06-20 Add Arm control and urdf in sim
    [Link_1.stl, Link_2.stl, base_link.stl, mppi.csv, mppi.urdf]
2025-06-21 Arm assembly
    [Manipulator.SLDASM]
2025-06-21 Add pitch presentation
2025-06-22 Modify material mass
    [Base.SLDPRT, Base.STEP, Manipulator.SLDASM, XM,H-430_idler.SLDASM, XM,H-430_idler.stp, arm1.SLDPRT, arm1.STEP, connector1.SLDPRT]
2025-06-22 New URDF and mesh
    [Link_1.STL, Link_2.STL, Manipulator.SLDASM.csv, Manipulator.SLDASM.urdf, base_link.STL]
2025-06-22 New "mppi" urdf and mesh
    [Link_1.STL, Link_2.STL, Manipulator.SLDASM, base_link.STL, mppi.csv, mppi.urdf]
2025-06-22 Clear workspace
    [Link_1.STL, Link_1.stl, Link_2.stl, Manipulator.SLDASM.csv, Manipulator.SLDASM.urdf, base_link.STL, base_link.stl, mppi.csv]
2025-06-22 RoboEnv Workspace first add
    [Link_1.stl, Link_2.stl, base_link.stl, mppi.csv, mppi.urdf]
2025-07-24 V0.1.0 Modified connector for better strength and print.
    [new connector1.SLDPRT, new connector1.STEP]
2025-07-28 New Arm 15N with sim
    [arm1.SLDPRT, arm1.STEP]
2025-08-05 V0.1.1 better motor control
2025-08-05 V0.2.0 Add mojuco sim, with sync real function
    [Link_1.stl, Link_2.stl, base_link.stl, mjmodel.xml, mppi.urdf]
2025-08-06 V0.1.1New Arm 15N with sim
    [arm1.SLDPRT, arm1.STEP]
2025-08-06 V0.1.2 shorter arm @20N
    [arm1.SLDPRT, arm1.STEP]
2025-08-06 V0.1.3 Add drone
    [drone.SLDPRT]
2025-08-06 V0.1.4 update weight
    [arm1.SLDPRT, new connector1.SLDPRT]
2025-08-06 V0.1.5 Add a open state claw
    [claw open.SLDPRT]
2025-08-06 V0.2.0 new whole body
    [Manipulator.SLDASM]
2025-08-06 V0.2.1 New URDF
    [Link_1.STL, Link_2.STL, base_link.STL, mppi.urdf]
2025-08-06 V0.2.2 Better dual control code
    [mjmodel.xml]
2025-08-07 V0.3.0 First version of full 3d design
    [battery.SLDPRT, drone.SLDPRT, motor2drone.SLDPRT, motor2drone.STEP, raspi_shelf.SLDPRT, raspi_shelf.STEP]
2025-08-08 V0.3.1 XML with drone but no drone2arm and no raspi
    [Link_1.STL, Link_1.stl, Link_2.STL, Link_2.stl, base_link.STL, base_link.stl, mjmodel.xml, mppi.urdf]
2025-08-08 V0.4.0 First complete version of 3d model and urdf
    [Link_1.STL, Link_2.STL, SkyGrip_URDF.csv, SkyGrip_URDF.urdf, base_link.STL, motor2drone.SLDPRT, mppi.csv, mppi.urdf]
2025-08-08 V0.4.1 Rename folder and add a draft readme
    [Link_1.stl, Link_2.stl, base_link.stl, mppi.csv, mppi.urdf]
2025-08-08 V0.4.2 Centered and orientated model
    [Link_1.STL, Link_2.STL, SkyGrip_URDF.csv, SkyGrip_URDF.urdf, drone.SLDPRT]
2025-08-08 V0.4.3 New XML in mujoco with centered and oriented
    [Link_1.STL, Link_2.STL, SkyGrip_URDF.urdf, mjmodel.xml]
2025-08-09 V0.5.0 Add MPPI controller basic
    [drone_with_rotors.xml]
2025-08-10 V0.4.5 More accurate diaginertia
    [Link_2.stl, mjmodel.xml]
2025-08-10 V0.5.1 Add MPPI controller (general force and torque) and 10 waypoints
    [drone_direct_control.xml]
2025-08-10 V0.4.6 80% accurate motor, Add realtime simulation
    [mjmodel.xml]
2025-08-10 V0.5.2 Integrate joints' moving at hover stage
2025-08-10 V0.4.7 90% accurate arm motor
    [mjmodel.xml]
2025-08-11 V0.4.9 Remove 4-wings-force-control sim
    [drone_with_rotors.xml]
2025-08-11 V0.5.0 Add motors sim function and 90% accuate parameters
    [drone_direct_control.xml]
2025-08-15 V0.6.0 use sbmpc to realize the MPPI algorithm (include hover and move as a whole)
    [Link_1.STL, Link_2.STL, base_link.STL, cf2_0.obj, cf2_1.obj, cf2_2.obj, cf2_3.obj, cf2_4.obj]
2025-08-17 V0.6.1 use sbmpc (move drone and arm together, error: 0.038m))
    Excellent performance!!
    [drone_arm_dynamics_stable.py, quadrotor_arm_test.py, task_configs.py]
2025-08-18 V0.6.2 correct motor model
2025-08-18 V0.6.3 Add two L shape design
    [L_for_big.SLDPRT, L_for_small.SLDPRT]
2025-08-18 V0.6.4 Add step
    [L_for_big.SLDPRT, L_for_big.STEP]
2025-08-19 V0.6.6 Add Supersonic and realsense model
    [L_for_big.SLDPRT, L_for_big.STEP, L_for_small.SLDPRT, Link_2_new.SLDASM, Link_2_new.SLDPRT, Link_2_new.STL, board_connector.SLDPRT, connector1.SLDPRT]
2025-08-20 V0.6.8 Update new link2 stl
    [Link_2_new.SLDASM, Link_2_new.SLDPRT, Link_2_new.STL]
2025-08-20 V0.6.9 Integrate 3 sim envs.
    [Link_1.STL, Link_1.stl, Link_2.STL, Link_2.stl, SkyGrip_URDF.urdf, base_link.STL, base_link.stl, cf2_0.obj]
2025-08-26 V0.7.1 Sync real to mppi controller And send ctrl to arm
2025-08-26 V0.7.2 Add dynamic step 3 with motor e_break
2025-08-26 V0.7.4 Add drone foot
    [drone_foot.SLDPRT, drone_foot.STEP]
2025-08-27 V0.7.6 Optimize for 40ms step time
    Sim step time: 22.42 ms
    Send torque time: 0.22 ms
    Get state time: 4.83 ms
    Mujoco step time: 1.13 ms
2025-08-28 V0.7.7 delete useless files
    [cf2_0.obj, cf2_1.obj, cf2_2.obj, cf2_3.obj, cf2_4.obj, cf2_5.obj, cf2_6.obj, cf2_collision_0.obj]
2025-08-31 V0.7.10 Add Arm part
    [arm.SLDPRT]
2025-09-01 V0.7.12 Arm sin wave test and plot
2025-09-02 V0.7.13 Arm noise speed add
    [quadrotor_arm_test.py]
2025-09-02 V0.7.15 Fix arm dynamics
    [drone_arm_dynamics_stable.py, task_configs.py]
2025-09-02 V0.8.0 Remote arm control via UDP to raspi
2025-09-04 V0.8.2 Bug Fix: get real arm state jitter
    [quadrotor_arm_test.py]
2025-09-04 V0.8.4 Send 0 torque when offline ->rpi5
2025-09-04 V0.8.5 New drone foot
    [drone_foot.SLDPRT, drone_foot.STEP]
2025-09-04 V0.8.6 Correct skygrip design mate
    [Manipulator.SLDASM, Skygrip.SLDASM]
2025-09-04 V0.8.7 Add arm FEA simulation
    [arm.SLDPRT]
2025-09-04 V0.8.8 Modify cost, add auto zero thrust
2025-09-05 V0.8.9 Add compare plots
    [board_connector.SLDPRT]
2025-09-05 V0.8.10 Add pics for mechanic design and rename
    [arm_link.SLDPRT, arm_link.STEP, connector_joint1.SLDPRT, connector_joint2.SLDPRT]
2025-09-06 V0.9.0 Start for thesis. Add Myopic、RS-MPC compare algorism
2025-09-06 V0.9.2 Add Arm FEA pic
2025-09-06 V0.9.3 Draw heat map for H, S
    [EE_Square_H_S_rmse.csv]
2025-09-06 V0.9.4 MPPI vs RS-MPC vs Myopic
    [EE_Square_rmse_compare.csv]
2025-09-08 V0.9.5 Add compare and reports pics
    [EE_Square_H_S_rmse.csv, EE_Square_RMSE_compare.csv]
2025-09-08 V0.9.2 Enhance strength of motor2drone
    [motor2drone.SLDPRT, motor2drone.STEP, new connector1.STEP]
2025-09-08 V0.9.3 Add foot and correct part for assembly
    [Skygrip.SLDASM]
2025-09-11 V0.9.4 Correct main test code
    [quadrotor_arm_test.py]
2025-09-15 V0.10.2 Add rpi5 motor control from UDP
2025-09-17 V0.10.3 Fix MPPI control sequence
    [quadrotor_arm_test.py]
2025-09-17 V0.10.4 Add time measure
    TODO: Add filter and Interpolation to reach 200Hz
2025-09-19 V0.10.5 Separate Arm and drone ctrl on rpi5
